RonaldinDuCaus/EsteiraV2/versao-4/VALIDACAO.md

# Validação da Versão 4 — 08/11/2026

## Servidor e interface

- **37 testes Python aprovados**, incluindo integração com PostgreSQL 16.15 real, isolado em `127.0.0.1` e banco de teste. Cobrem sessão, tokens separados, comandos/ACK, ciclo, duplicação de upload, boot antigo, parada, expiração e resultado tardio; novos testes verificam home/painel, fronteiras públicas, catálogo, acesso de usuário inativo, imagens e ausência de credenciais padrão.
- **Três arquivos de testes Node aprovados**: `factory-ui.test.cjs`, `app.test.cjs` e `pages.test.cjs`. Cobrem estados dos controles, polling, logout, prévia sem comandos reais e estrutura das novas páginas. Sintaxe dos scripts conferida.
- Home e painel abertos em navegador local. Botões Calibrar/Iniciar/Parar visíveis e desabilitados na prévia, aviso de demonstração, módulos e estados conferidos. Home também conferida em viewport 390 × 844, sem transbordamento horizontal.
- Resultados de reconhecimento nos testes de fluxo são controlados pela suíte; não medem precisão do modelo YOLOv8.

As dependências de testes emitem aviso de depreciação de TestClient/httpx; os testes passaram com as versões fixadas.

## Firmwares compilados

Arduino CLI oficial, Arduino-ESP32 **3.3.12**, ArduinoJson **7.4.3**, bundle CA público habilitado, sem credenciais reais nos ensaios:

| Firmware | FQBN | Flash | Globais |
|---|---|---|---|
| Esteira V4 | `esp32:esp32:esp32` | 1.139.503 bytes (86%) | 49.596 bytes (15%) |
| ESP32-CAM V4 | `esp32:esp32:esp32cam` | 1.229.273 bytes (39%) | 60.960 bytes (18%) |

A compilação final do motor usou SSID/token fictícios não vazios para incluir o caminho de rede/HTTPS, que pode ser eliminado pelo otimizador com configuração vazia. Os `config.h` temporários foram removidos após conferência. Nenhuma placa foi gravada.

## Configuração e publicação

Segredos novos gerados localmente com fonte criptográfica; cinco valores distintos de 32 bytes aleatórios. Tokens do `.env` e dos respectivos `config.h` privados conferidos sem imprimir os valores. Configurações reais são ignoradas pelo Git; exemplos públicos usam marcadores. Versões entregues anteriormente preservadas.

O domínio resolve por DNS, mas a verificação HTTPS retornou `RemoteCertificateNameMismatch`. Não foi desativada a validação TLS. Foram incluídos exemplos de Nginx e Caddy para configurar certificado correto; não houve alteração do servidor existente.

## Não executado / pendente

- Docker build e instalação na VPS; Docker não está disponível neste computador.
- Inferência real: falta `best.pt` treinado e mapa definitivo de componentes.
- Medição de latência, consumo de memória e precisão na VPS real.
- Gravação de placas, teste de Wi-Fi, foco/iluminação e operação física completa.
- Correção do certificado do domínio e confirmação de HTTPS válido.
- Confirmação de alimentação adequada ao motor, divisor ECHO e emergência física.

## Ensaio físico proposto

Com alimentação adequada e motor inicialmente desabilitado, conferir calibração/sensor, comunicação autenticada e reserva de captura. Depois testar uma peça por vez: reconhecida, desconhecida, ambígua e peça que permanece no sensor. Simular rede desligada, câmera indisponível, worker parado, análise lenta, resultado de boot anterior e reinício durante o ciclo. Nenhuma dessas falhas pode aprovar movimento. Registrar o resultado real antes de declarar o conjunto validado.

## Tentativa de gravação da ESP32-CAM — 08/11/2026

Log enviado pelo usuário: compilação concluída, 1.229.353 bytes de flash (39%) e 60.960 bytes globais (18%). O esptool 5.3.1 conectou à COM4, mas durante o envio do stub ocorreu erro pySerial `Cannot configure port`, `PermissionError(13)`, acesso negado pelo Windows. A gravação não foi concluída; o log não confirma execução do firmware, câmera pronta ou comunicação com a VPS.

O Windows identifica a COM4 como adaptador USB serial FTDI. Foi orientado fechar programas que usam a porta, reconectar o USB, confirmar a porta e tentar Upload Speed 115200, com cabo de dados e conexão USB direta. Persistindo, conferir alimentação e driver FTDI oficial. Causa ainda não determinada; nenhuma configuração de driver foi alterada pelo assistente.

O aviso de cristal estimado em 0,46 MHz, normalizado para 26 MHz, não confirma a frequência física do cristal nem defeito na placa. Não alterar cristal ou frequência de flash com base nesse aviso. Referências: [Espressif — erros seriais](https://docs.espressif.com/projects/esptool/en/latest/esp32/troubleshooting.html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) e [menu Upload Speed](https://docs.espressif.com/projects/arduino-esp32/en/latest/guides/tools_menu.html#upload-speed).

## Diagnóstico da base ESP32-CAM-MB — 08/11/2026

O usuário confirmou que o ESP32 comum grava pela COM3 e a câmera usa uma base ESP32-CAM-MB na COM4. A numeração diferente é normal. Consulta do Windows: COM4 identificada como FTDI, driver 2.12.36.20, ProblemCode 0. Isso confirma reconhecimento do dispositivo, sem comprovar estabilidade do driver/adaptador.

A Arduino IDE mostrou novamente `Cannot configure port`/acesso negado e também uma notificação `Serial port busy`. Foi cancelada pela interface uma tentativa que já havia retornado erro. Nenhuma placa foi gravada, nenhum driver ou firmware foi alterado; o problema permanece em diagnóstico.

Correção da orientação anterior sobre velocidade: o perfil AI Thinker instalado não oferece menu Upload Speed e define upload em 460800 no boards.txt. Não foi alterado esse arquivo. Para um ensaio serial da base isolada pode-se usar 115200, sem confundir a velocidade do Monitor Serial com a velocidade de gravação.

Próximo teste pendente: desconectar USB, desencaixar a ESP32-CAM da MB e reconectar só a base vazia; testar abertura da COM4. O usuário informou que a câmera ainda está encaixada; a abertura da porta pelo assistente foi adiada. Falha também com base vazia aponta para o caminho USB/driver/base; abertura estável permite investigar depois encaixe, alimentação e comunicação com a câmera. Não há confirmação de defeito na câmera ou na base.

## Ensaios de acesso serial da câmera — 08/11/2026

- O usuário retirou a ESP32-CAM da base MB. A primeira abertura da COM4 falhou enquanto havia Monitor Serial ativo. Após fechar efetivamente a aba do monitor, a base vazia abriu em 115200, aceitou 460800 e voltou a 115200, sem transmitir dados. Isso valida apenas esse ensaio da interface serial em repouso, não a gravação ou a câmera completa.
- Com a câmera novamente encaixada, uma nova gravação pela Arduino IDE falhou durante `Uploading stub flasher`, com `Cannot configure port` e erro Windows 5. Estimativas de cristal e identificação variaram entre tentativas; não foram usadas para alterar cristal, flash, eFuses ou firmware.
- Foram feitos ensaios de consulta ROM `read-mac`, sem stub nem escrita de flash, em 115200 e com a IDE fechada. Tanto esptool 5.3.1 do Arduino quanto esptool 4.11.0 oficial instalado em pasta isolada falharam na conexão com a mesma classe de erro pySerial. Algumas tentativas deixaram processo pendente, exigindo reconectar o USB para liberar a interface.
- A porta variou entre COM4 e COM5 depois de reconexões do usuário. Usar sempre a porta atualmente enumerada. O usuário confirmou que o cabo funcionou ao gravar o ESP32 comum; esse dispositivo usa CH9102, enquanto a base da câmera aparece como FTDI.
- Driver FTDI instalado: 2.12.36.20, sem código de problema permanente no PnP. Nenhum driver foi alterado. A sessão do assistente não tem elevação administrativa do Windows; uma reinstalação do driver deverá ser executada pelo usuário como administrador.
- Gravação da ESP32-CAM continua pendente. Não há diagnóstico conclusivo de defeito na câmera ou base, nem validação de captura/reconhecimento. Próximos passos: reinstalação do pacote FTDI oficial e novo ensaio; persistindo, comparar outra base/conversor e verificar alimentação/encaixe.

### Instalador FTDI preparado — 08/11/2026

O pacote CDM 2.12.36.20 foi obtido pelo navegador no [host oficial FTDI](https://ftdichip.com/wp-content/uploads/2025/03/CDM2123620_Setup.zip), extraído localmente e teve assinatura Authenticode do executável verificada como `Valid`, editor Future Technology Devices International Ltd. SHA256 do ZIP: E412945BB98F96B3296A89A549E6B617129E5481E0BE2FE5410247857C507796. SHA256 do EXE: 6B4985913C5F8B0B9656E8BAA6F1193B2B7EF3385F67DDC09FBA83A670B5444D.

É a mesma versão instalada, para tentativa de reinstalação. Instalador não foi executado pelo assistente: sessão sem elevação administrativa do Windows. Foi entregue ao usuário para execução como administrador; instalação e novo ensaio ainda aguardam confirmação. Os binários de driver ficam fora do repositório do projeto; nenhum firmware, token ou configuração de placas foi alterado.

### Reinstalação informada pelo usuário — 08/11/2026

O usuário informou ter concluído a instalação do pacote FTDI como administrador. A porta voltou a aparecer como COM4, versão 2.12.36.20 e ProblemCode 0. A consulta seguinte encontrou acesso negado antes de abrir a porta; foi identificado um processo Python da consulta comparativa anterior ainda preso na interface. O assistente solicitou o encerramento desse processo, mas o Windows não concluiu a finalização no prazo de 2 s. Foi solicitada nova desconexão USB de 10 s e reconexão, mantendo a IDE fechada, antes do reteste. Ainda não há confirmação de que a reinstalação resolveu a gravação.

## Portas USB e placa reserva — 08/11/2026

| Porta observada | Interface | Resultado registrado |
|---|---|---|
| COM3 | CH9102, driver WCH 2.1.2025.7 | Gravação no ESP32 da esteira confirmada pelo usuário |
| COM4 / COM5 | FTDI, driver 2.12.36.20 | Base MB da câmera: consultas/gravação instáveis, falha pySerial e processos pendentes |
| COM6 | CH9102, mesmo driver WCH 2.1.2025.7 | ESP32 reserva: porta abriu e recebeu resposta; esptool informou boot normal 0x13, exigindo entrada manual no modo de gravação |

Os números COM são identificadores atribuídos pelo Windows, não classificações de qualidade ou compatibilidade. Duas placas com o mesmo CH9102 podem receber números diferentes por serem interfaces distintas. Renomear uma porta não troca o conversor USB, o driver ou o modo de inicialização do ESP32.

Após a reinstalação FTDI e reconexão, o conversor chegou a apresentar Código 10 (falha de inicialização do dispositivo), sem criar a COM. O usuário reiniciou o Windows: código voltou a 0 e a COM4 reapareceu. Uma consulta ROM respondeu com cristal 40 MHz; o ensaio seguinte voltou a mostrar identificação/cristal incoerentes e erro durante o envio do stub. A gravação da câmera ainda não foi concluída.

O usuário disponibilizou outro ESP32, preservando o que já está no shield da esteira. A placa reserva está na COM6. Antes de orientar jumpers ou gravar, falta confirmar seu modelo em modo ROM, a alimentação 5 V disponível e a ligação temporária como ponte USB-UART. O teste atual pede segurar BOOT, pressionar/soltar EN/RST e soltar BOOT; a consulta não altera o firmware da placa reserva.
