RonaldinDuCaus/EsteiraV2/versao-4/site/docs/ROADMAP.md

# Pendências após a Versão 4

- Fornecer modelo YOLOv8 treinado e mapa real para os componentes cadastrados.
- Confirmar capacidade da VPS, instalar e medir tempo de inferência.
- Instalar a V4 e corrigir o certificado HTTPS de minifabrica.kronux.com.br (erro de hostname observado). Credenciais locais novas já foram preparadas; ainda não foram instaladas na VPS nem nas placas.
- Adequar alimentação do motor, confirmar divisor ECHO e validar emergência física.
- Ensaiar sensor, captura, reconhecimento, rejeição e saída com peças reais.
- Treino automático pela dashboard e microSD não estão implementados nesta versão.
