RonaldinDuCaus/EsteiraV2/versao-2/site/docs/ROADMAP.md

# Próximas etapas

1. Validar cadastro, painel e histórico na VPS.
2. Implementar geração de assinaturas visuais com MobileNetV3Small.
3. Armazenar vetores de referência e comparar novas capturas.
4. Adicionar limite de confiança e resultado desconhecido.
5. Integrar firmware da ESP32-CAM.
6. Integrar ESP32 da esteira, sensor, motor e LCD.
7. Adicionar domínio, HTTPS, backup e monitoramento.
8. Criar documentação final em PDF.
9. Gerar ZIP de demonstração e ZIP de instalação limpa.
