RonaldinDuCaus/EsteiraV2/(commit log)

2026-11-08 Adiciona testes 1 a 5 da esteira e documentacao de bancada
2026-11-08 Organiza versao 1 e define procedimento de entregas versionadas
2026-11-08 Adiciona versao 2 com site e conexoes ESP32 separados
2026-11-08 Adiciona versao 3 com ESP32-CAM YOLOv8 e controle pela dashboard
2026-11-08 docs: registra tentativa de gravacao da camera V4
2026-11-08 docs: acompanha diagnostico da base ESP32-CAM-MB
2026-11-08 docs: registra pacote FTDI oficial pronto para reinstalacao
2026-11-08 docs: explica portas COM e identifica ESP32 reserva
